urish/tt-simon-pmod/(threads)

Thread 1 (2024-04-30):

Use a pull resistor for seginv pin

urish, 2024-04-30:
Currently, we hard wire `seginv` it to GND / VCC (depending on the solder jumper position). This interferes when interacting with other projects that use the `ui_in[4]` input, e.g. when reading the chip's ROM. Instead, we should use a pull resistor for this pin.

Closed 2024-05-02.
