urish/tt-simon-pmod/(commit log)

2023-10-18 feat: initial schematics
    [simon-says-pmod.kicad_pcb, simon-says-pmod.kicad_sch]
2023-12-14 fix: pmod pinout error (dig1/dig2 pins)
    [simon-says-pmod.kicad_sch]
2023-12-14 feat: initial PCB layout
    [simon-says-pmod.kicad_pcb]
2023-12-15 refactor: replace 7-segment with a better part
    Use a single part with two digits instead of one part per digit. Also reduce the amount of resistors, and add a 3D model for the pushbutton.
    [simon-says-pmod.kicad_pcb, simon-says-pmod.kicad_sch]
2023-12-15 feat(pcb): make LEDs different colors in the 3D view
    [simon-says-pmod.kicad_pcb]
2023-12-15 feat(bom): add JLCPCB Assembly part numbers
    [simon-says-pmod.kicad_pcb, simon-says-pmod.kicad_sch]
2023-12-15 feat(pcb): silk screen legend for 7-segment polarity select
    [simon-says-pmod.kicad_pcb]
2023-12-15 docs: add PCB render
2023-12-15 feat(pcb): add KiCad and Wokwi logos
    [simon-says-pmod.kicad_pcb]
2024-01-02 feat(pcb): placeholder for JLCPCB order number
    [simon-says-pmod.kicad_pcb]
2024-04-29 feat(pcb): connect the 7-segment DP pin to uio[7]
    Board rev 2.0
    [simon-says-pmod.kicad_pcb, simon-says-pmod.kicad_sch]
2024-04-29 refactor: migrate to kicad-tinytapeout-pmod-lib
    Use the official Tiny Tapeout PMOD KiCad library, which provides the PMOD headers symbol and footprint
    [simon-says-pmod.kicad_pcb, simon-says-pmod.kicad_sch]
2024-05-02 fix: replace 7-segment resistors with 220R
    Even with 220R, it should be bright enough at 3.3V, and should draw less current from the ASIC
    [simon-says-pmod.kicad_pcb, simon-says-pmod.kicad_sch]
2024-05-02 fix: use a pull resistor for seginv pin #1
    [simon-says-pmod.kicad_pcb, simon-says-pmod.kicad_sch]
2024-07-10 chore: update kicad-tinytapeout-pmod-lib submodule
2024-07-10 fix: bump green LED resistor to 1K
    The green LED is reportedly too bright, compared with the other LEDs.
    With the current 220R setup, I measured the following currents:
    | LED | Current |
    |--------|---------|
    | Red | 3.4 mA |
    | Yellow | 3.25 mA |
    | Green | 2.17 mA |
    | Blue | 1.47 mA |
    With the new 1k resistor, the green LED current is estimated to go down to about 0.5 mA.
    [simon-says-pmod.kicad_pcb, simon-says-pmod.kicad_sch]
2024-07-10 docs: PMOD -> Pmod
    [simon-says-pmod.kicad_sch]
2024-07-10 docs: link to PDF schematic
2024-10-28 docs: update board render image for rev 2.0
    [simon-says-pmod.kicad_pcb]
