urish/tt-simon-pmod/(notices)

Notices in the files:
simon-says-pmod.kicad_pcb:
(C) 2024 Uri Shaked
